rgrokett/ESP8266_ISSPointer/script/README.md

# ESP8266_ISSPointer
Servo driven International Space Station (ISS) Tracking Pointer

Now modified for Python 3.11:
isspointer.py	-- for standard Raspberry Pi or Linux server<br>
isspointer2.py	-- for Raspberry Pi running Adafruit LCD display and audio
testmotors.sh   -- Test your ESP Pointer. $ sh testmotors.sh
testpointer.py  -- Test the Pointer using $ python3.11 testpointer.py

To run in background:
sudo nohup python3.11 ./isspointer.py &

See the ESP8266_ISSPointer.pdf document for full details
