rgrokett/ESP8266_ISSPointer/(threads)

Thread 1 (2024-06-25):

Servo altitude angle wrong - may need adjusting in .ino

rgrokett, 2024-06-25:
By default the new Arduino Servo library sets the servo to 1500 us. which translates to 45 degrees on ESP8266.

**Servo.h**
#define MIN_PULSE_WIDTH       544     // the shortest pulse sent to a servo
#define MAX_PULSE_WIDTH      2400     // the longest pulse sent to a servo
#define DEFAULT_PULSE_WIDTH  **1500**     // default pulse width when servo is attached

So, If your servo is not zero altitude upon startup of the ESP8266, you will need to update the attach() and add the writeMicroseconds(544)  line of code:

**ISSPointer.ino**
 // prepare Servo GPIO
  myservo.attach(SVRO, 544, 2400);  // <<< CHANGE THIS to add default start, end range microseconds
  myservo.write(0);  // this should set servo to 0 altitude
  myservo.writeMicroseconds(544);  // <<<ADD THIS LINE
