rgrokett/ESP8266_ISSPointer/(commit log)

2016-01-02 Corrected Azimuth to Altitude
    [AltAzPointer.ino]
2016-01-09 minor fix for resetting pointer
    [isspointer2.py]
2016-01-16 Fix for overhead sounds bug Improved url calls to AltAz
    [isspointer2.py]
2017-11-15 Added missing duration variable to main()
    [isspointer.py]
2020-06-17 Fix if tr/ts data comes back None
    [isspointer.py, isspointer2.py]
2020-07-08 small fix for Quiet Time end time
    [isspointer2.py]
2020-08-19 Added catch TLE parse error
    [isspointer.py, isspointer2.py]
2024-06-25 Update AltAzPointer.ino
    See issue for reason
    [AltAzPointer.ino]
